diondokter/induction-heater/hardware/induction-heater-manual-control.asc

C1: cap; 220n
L1: ind; 220µ
L2: ind; 220µ
L3: ind; 87.5µ
M1: nmos; Si7336ADP
M2: nmos; Si7336ADP
R1: res; 100K
R2: res; 120
R3: res; 10k
R4: res; 120
V1: voltage; 48
V2: voltage; PULSE(0 12 0 1p 1p 12.5u 25u)
V3: voltage; PULSE(0 12 12.5u 1p 1p 12.5u 25u)
Named nets: 0, MOS_G_R, MOS_G_L, BUS_R, BUS_L
.tran 0 20m 19.8m 0.0000001 startup
