diondokter/induction-heater/hardware/induction-heater-controller/induction-heater-controller.kicad_pcb

## KiCad design hardware/induction-heater-controller/induction-heater-controller.kicad_pcb (2023-08-05)

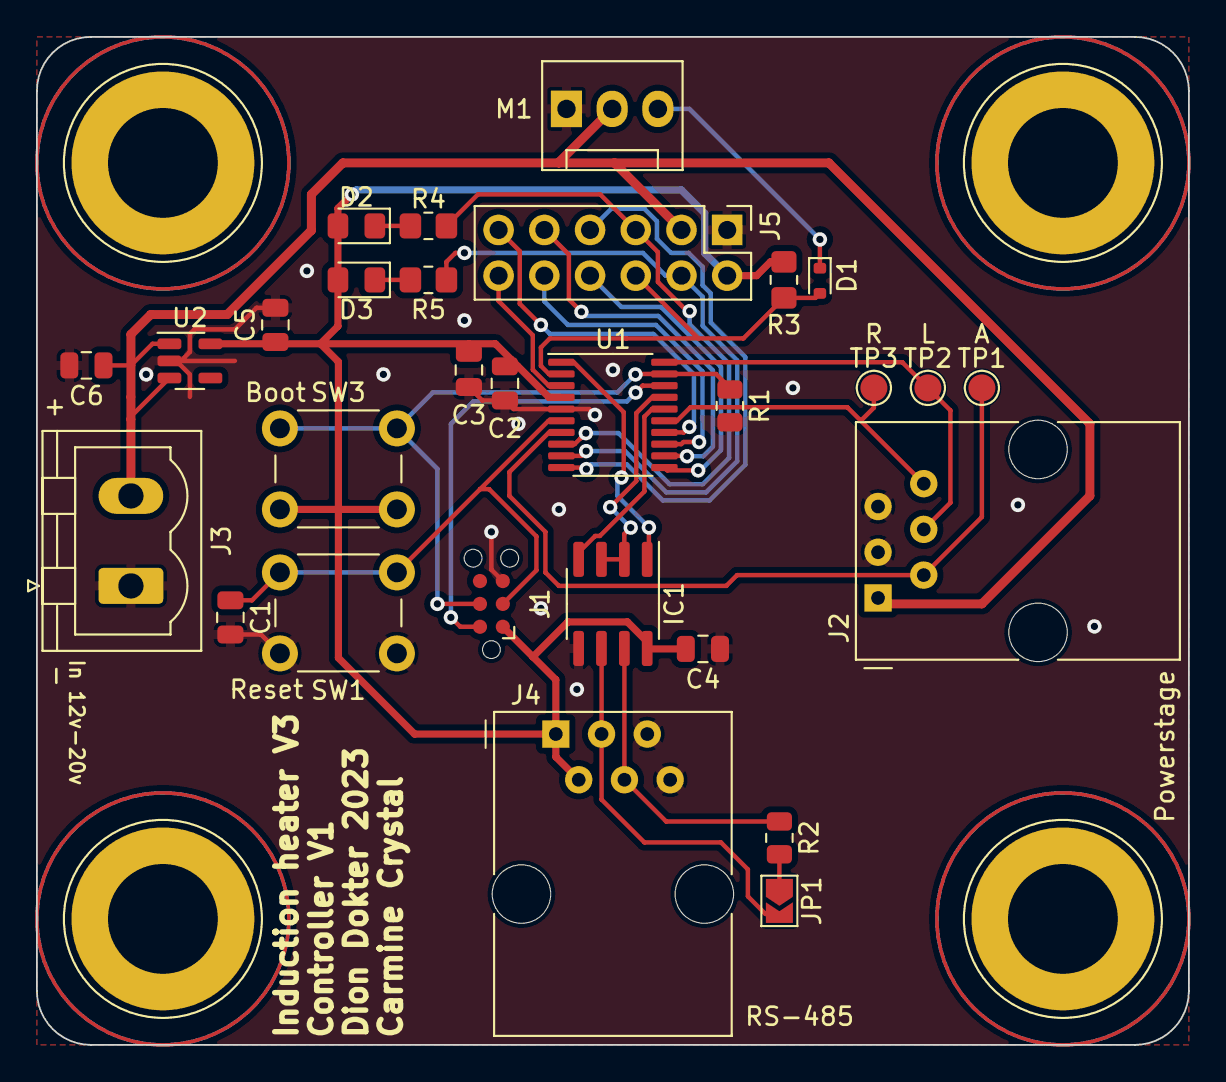
[picture p1: board induction-heater-controller.kicad_pcb from above]

Board: 2 copper layers, 64.0 x 56.0 mm, 33 parts (0 on the bottom side), 27 nets.

Parts:
C1, C2, C4: 100n; C_0805_2012Metric
C3: 4.7u; C_0805_2012Metric
C5, C6: 1u; C_0805_2012Metric
D1: D; D_SOD-523
D2, D3: LED; LED_0805_2012Metric_Pad1.15x1.40mm_HandSolder
H1, H2, H3, H4: MountingHole; Banana_Jack_1Pin
IC1: THVD1449DR; SOIC-8_3.9x4.9mm_P1.27mm
J1: Conn_ARM_SWD_TagConnect_TC2030-NL; Tag-Connect_TC2030-IDC-NL_2x03_P1.27mm_Vertical
J2, J4: RJ12; RJ12_Amphenol_54601
J3: Screw_Terminal_01x02; PhoenixContact_MSTBVA_2,5_2-G_1x02_P5.00mm_Vertical
J5: Conn_02x06_Top_Bottom; PinHeader_2x06_P2.54mm_Vertical
JP1: SolderJumper_2_Open; SolderJumper-2_P1.3mm_Open_TrianglePad1.0x1.5mm
M1: Fan_3pin; FanPinHeader_1x03_P2.54mm_Vertical
R1: 10k; R_0805_2012Metric
R2: 120; R_0805_2012Metric
R3: 10k; R_0805_2012Metric_Pad1.20x1.40mm_HandSolder
R4: 100; R_0805_2012Metric_Pad1.20x1.40mm_HandSolder
R5: 20; R_0805_2012Metric_Pad1.20x1.40mm_HandSolder
SW1, SW3: SW_Push; SW_PUSH_6mm
TP1, TP2, TP3: TestPoint; TestPoint_Pad_D1.5mm
U1: STM32G030F6Px; TSSOP-20_4.4x6.5mm_P0.65mm
U2: NCP718xSN330; SOT-23-5

Connections:
+3V3: C2.2, C3.2, C4.2, C5.1, D2.2 (A), D3.2 (A), IC1.8 (VCC), J1.1 (VCC), J4.1, J4.2, J5.2, R3.1, SW3.2, U1.4 (VDD), U2.5 (OUT)
ANALOG_L: J2.2, TP1.1, U1.7 (PA0)
DRIVER_L: J2.4, TP2.1, U1.20 (PB3/PB4/PB5/PB6)
DRIVER_R: J2.6, TP3.1, U1.15 (PB0/PB1/PB2/PA8)
FAN_TACHO: D1.2 (A), J5.6, R3.2, U1.2 (PC14/PB9)
GND: C1.2, C2.1, C3.1, C4.1, C5.2, C6.2, IC1.5 (GND), J1.5 (GND), J2.3, J2.5, J3.1, J4.5, J4.6, J5.1, M1.3 (-), R1.2, SW1.2, U1.5 (VSS), U2.2 (GND)
HEADER_7: J5.7, U1.10 (PA3)
HEADER_8: J5.8, U1.11 (PA4)
HEADER_9: J5.9, U1.12 (PA5)
HEADER_10: J5.10, U1.13 (PA6)
HEADER_11: J5.11, U1.14 (PA7)
HEADER_12: J5.12, U1.3 (PC15)
LED_G: J5.4, R5.1, U1.9 (PA2)
LED_R: J5.5, R4.1, U1.8 (PA1)
unnamed: D1.1 (K), M1.1 (Tacho)
unnamed: D2.1 (K), R4.2
unnamed: D3.1 (K), R5.2
unnamed: IC1.6 (A), J4.3, JP1.2 (B)
unnamed: IC1.7 (B), J4.4, R2.1
unnamed: C1.1, J1.3 (~RESET), SW1.1, U1.6 (NRST)
unnamed: JP1.1 (A), R2.2
RS485_DE: IC1.2 (~RE), IC1.3 (DE), U1.17 (PA12/PA10)
RS485_RX: IC1.1 (R), U1.1 (PB7/PB8)
RS485_TX: IC1.4 (D), U1.16 (PA11/PA9)
SWCLK: J1.4 (SWCLK), R1.1, SW3.1, U1.19 (PA14/PA15)
SWDIO: J1.2 (SWDIO), U1.18 (PA13)
VDC: C6.1, J2.1, J3.2, J5.3, M1.2 (+), U2.1 (IN), U2.3 (EN)
