diondokter/induction-heater/hardware/induction-heater-powerstage/induction-heater-powerstage.kicad_pcb

## KiCad design hardware/induction-heater-powerstage/induction-heater-powerstage.kicad_pcb (2023-08-05)

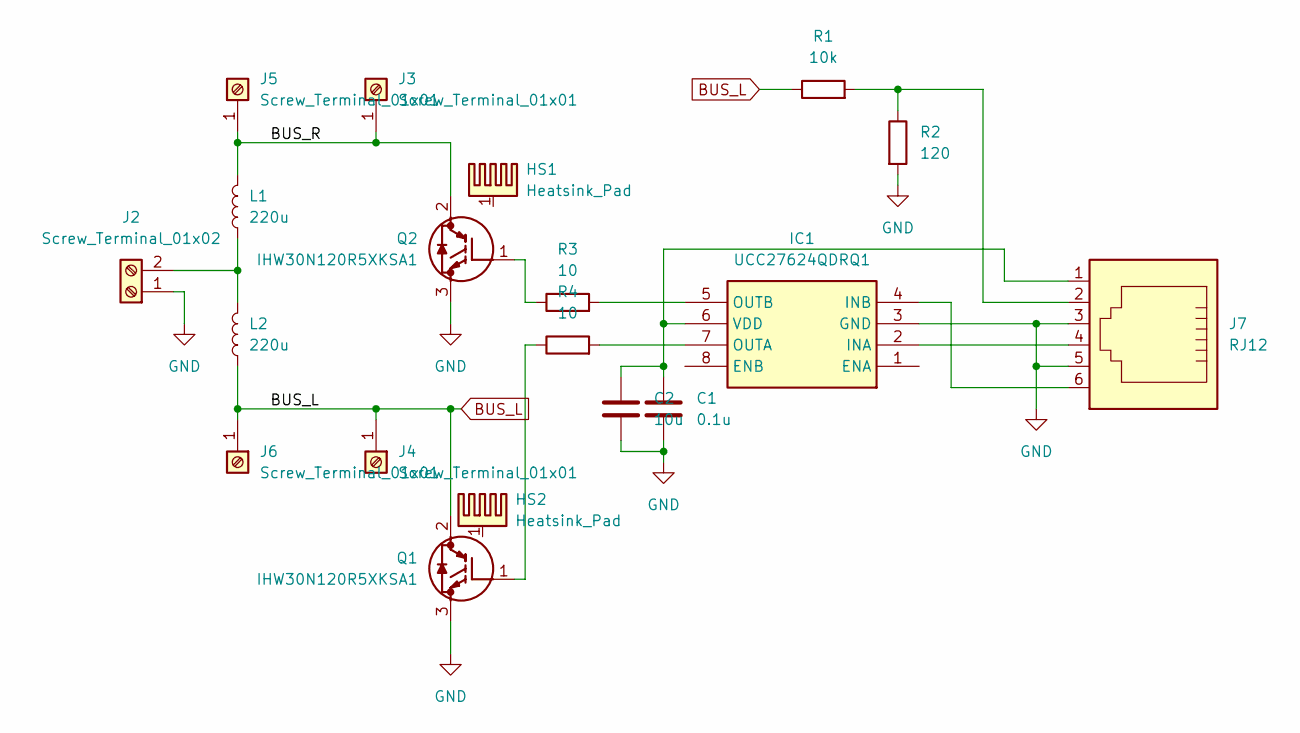
[picture p2: schematic induction-heater-powerstage.kicad_sch]

Parts:
C1: 0.1u; C_0805_2012Metric_Pad1.18x1.45mm_HandSolder
C2: 10u; C_0805_2012Metric_Pad1.18x1.45mm_HandSolder
HS1, HS2: Heatsink_Pad; Heatsink_Fischer_SK129-STS_42x25mm_2xDrill2.5mm; MPN 6398BG
IC1: UCC27624QDRQ1; SOIC127P600X175-8N; Mouser Part Number 595-UCC27624QDRQ1
J2: Screw_Terminal_01x02; PhoenixContact_MSTBVA_2,5_2-G_1x02_P5.00mm_Vertical; MPN TB007-508-02BE
J3, J4, J5, J6: Screw_Terminal_01x01; Banana_Jack_1Pin
J7: RJ12; RJ12_Amphenol_54601; MPN 54601-906WPLF
L1, L2: 220u; L_Toroid_Vertical_L31.8mm_W15.9mm_P13.50mm_Bourns_5700; MPN 2300HT-221-V-RC
Q1, Q2: IHW30N120R5XKSA1; TO544P521X1592X2557-3P; Mouser Part Number 726-IHW30N120R5XKSA1
R1: 10k; R_0805_2012Metric_Pad1.20x1.40mm_HandSolder
R2: 120; R_0805_2012Metric_Pad1.20x1.40mm_HandSolder
R3, R4: 10; R_0805_2012Metric_Pad1.20x1.40mm_HandSolder

Connections:
/BUS_R: J3.1, J5.1, L1.2, Q2.2 (C)
BUS_L: J4.1, J6.1, L2.1, Q1.2 (C), R1.1
GND: C1.2, C2.2, IC1.3 (GND), J2.1, J7.3, J7.5, Q1.3 (E), Q2.3 (E), R2.2
unnamed: IC1.2 (INA), J7.4
unnamed: IC1.4 (INB), J7.6
unnamed: IC1.7 (OUTA), R4.2
unnamed: IC1.5 (OUTB), R3.2
unnamed: C1.1, C2.1, IC1.6 (VDD), J7.1
unnamed: J2.2, L1.1, L2.2
unnamed: J7.2, R1.2, R2.1
unnamed: Q1.1 (G), R4.1
unnamed: Q2.1 (G), R3.1

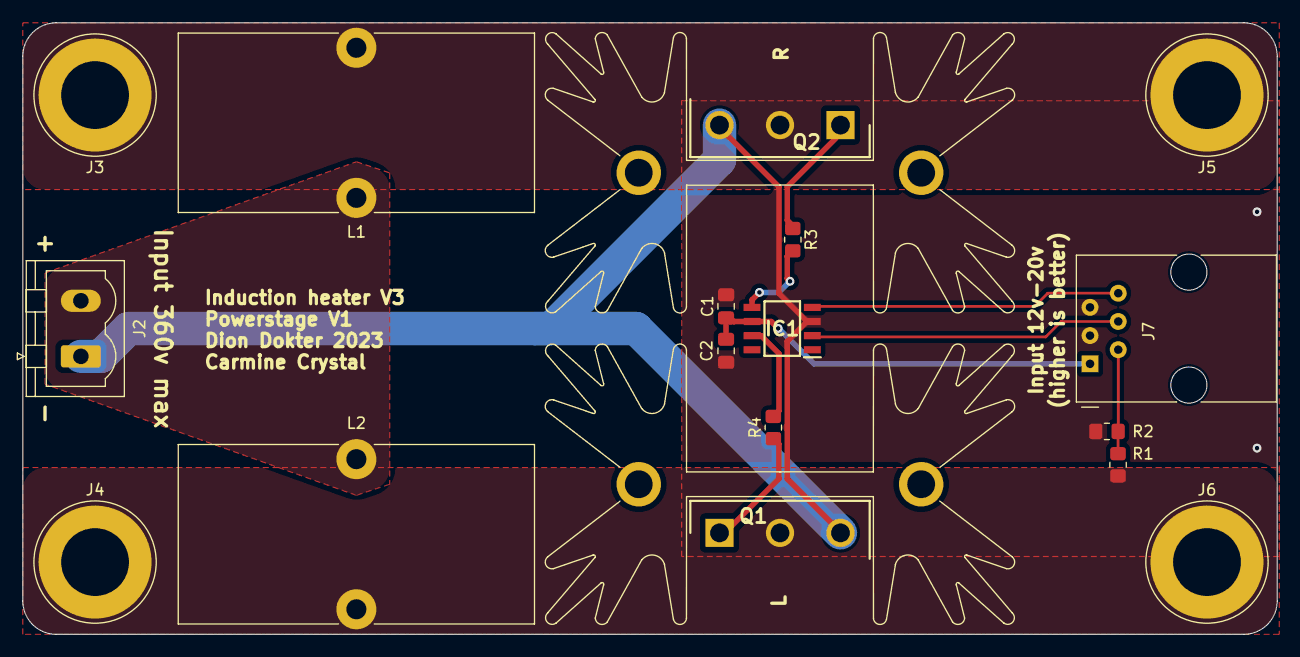
[picture p3: board induction-heater-powerstage.kicad_pcb from above]

Board: 2 copper layers, 112.8 x 55.0 mm, 19 parts (0 on the bottom side), 12 nets.
