diondokter/induction-heater/hardware/kicad/induction-heater.kicad_pcb

## KiCad design hardware/kicad/induction-heater.kicad_pcb (2023-01-13)

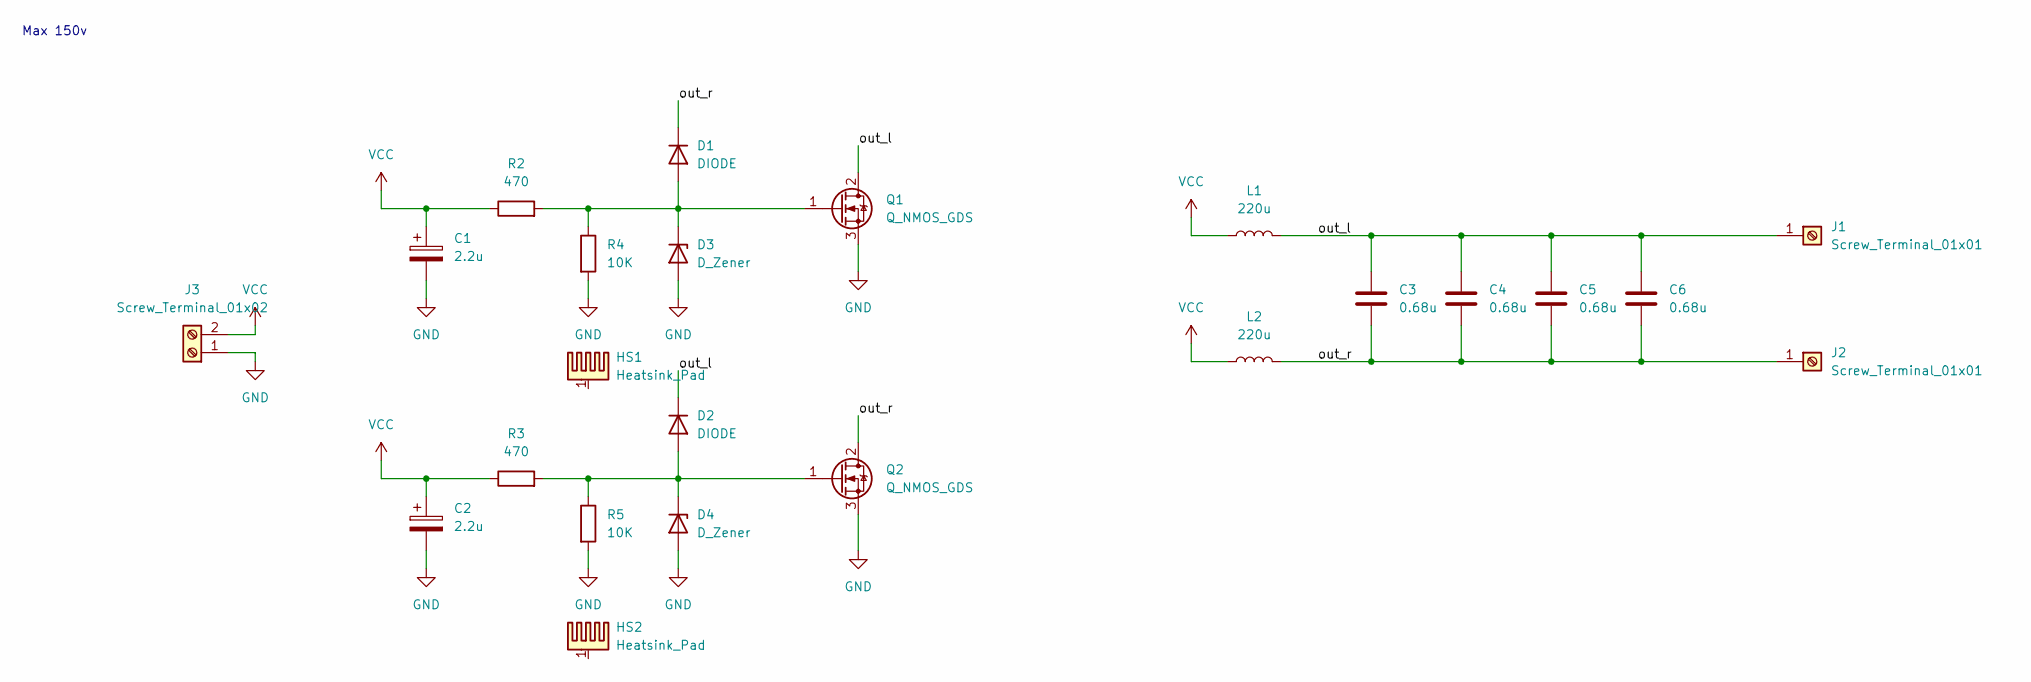
[picture p4: schematic induction-heater.kicad_sch]

Parts:
C1, C2: 2.2u; CP_Radial_D6.3mm_P2.50mm; MPN ESL225M250AE3AA
C3, C4, C5, C6: 0.68u; C_Rect_L31.5mm_W15.0mm_P27.50mm_MKS4; MPN MKS4O136806F00KYSD
D1, D2: DIODE; D_DO-41_SOD81_P7.62mm_Horizontal; MPN UF4005-E3/54
D3, D4: D_Zener; D_DO-15_P12.70mm_Horizontal; MPN 1N5927BRLG
HS1, HS2: Heatsink_Pad; Heatsink_Fischer_SK129-STS_42x25mm_2xDrill2.5mm; MPN 6398BG
J1, J2: Screw_Terminal_01x01; Banana_Jack_1Pin
J3: Screw_Terminal_01x02; PhoenixContact_MSTBVA_2,5_2-G_1x02_P5.00mm_Vertical; MPN TB007-508-02BE
L1, L2: 220u; L_Toroid_Vertical_L31.8mm_W15.9mm_P13.50mm_Bourns_5700; MPN 2300HT-221-V-RC
Q1, Q2: Q_NMOS_GDS; TO-220-3_Vertical; MPN NTP067N65S3H
R2, R3: 470; TO-220-2_Vertical; MPN AP851470RJ
R4, R5: 10K; R_Axial_DIN0516_L15.5mm_D5.0mm_P5.08mm_Vertical; MPN ROX3SJ10K

Connections:
/out_l: C3.1, C4.1, C5.1, C6.1, D2.1 (K), J1.1, L1.2, Q1.2 (D)
/out_r: C3.2, C4.2, C5.2, C6.2, D1.1 (K), J2.1, L2.2, Q2.2 (D)
GND: C1.2, C2.2, D3.2 (A), D4.2 (A), J3.1, Q1.3 (S), Q2.3 (S), R4.2, R5.2
unnamed: D1.2 (A), D3.1 (K), Q1.1 (G), R2.2, R4.1
unnamed: D2.2 (A), D4.1 (K), Q2.1 (G), R3.2, R5.1
VCC: C1.1, C2.1, J3.2, L1.1, L2.1, R2.1, R3.1

Notes on the sheet:
Max 150v

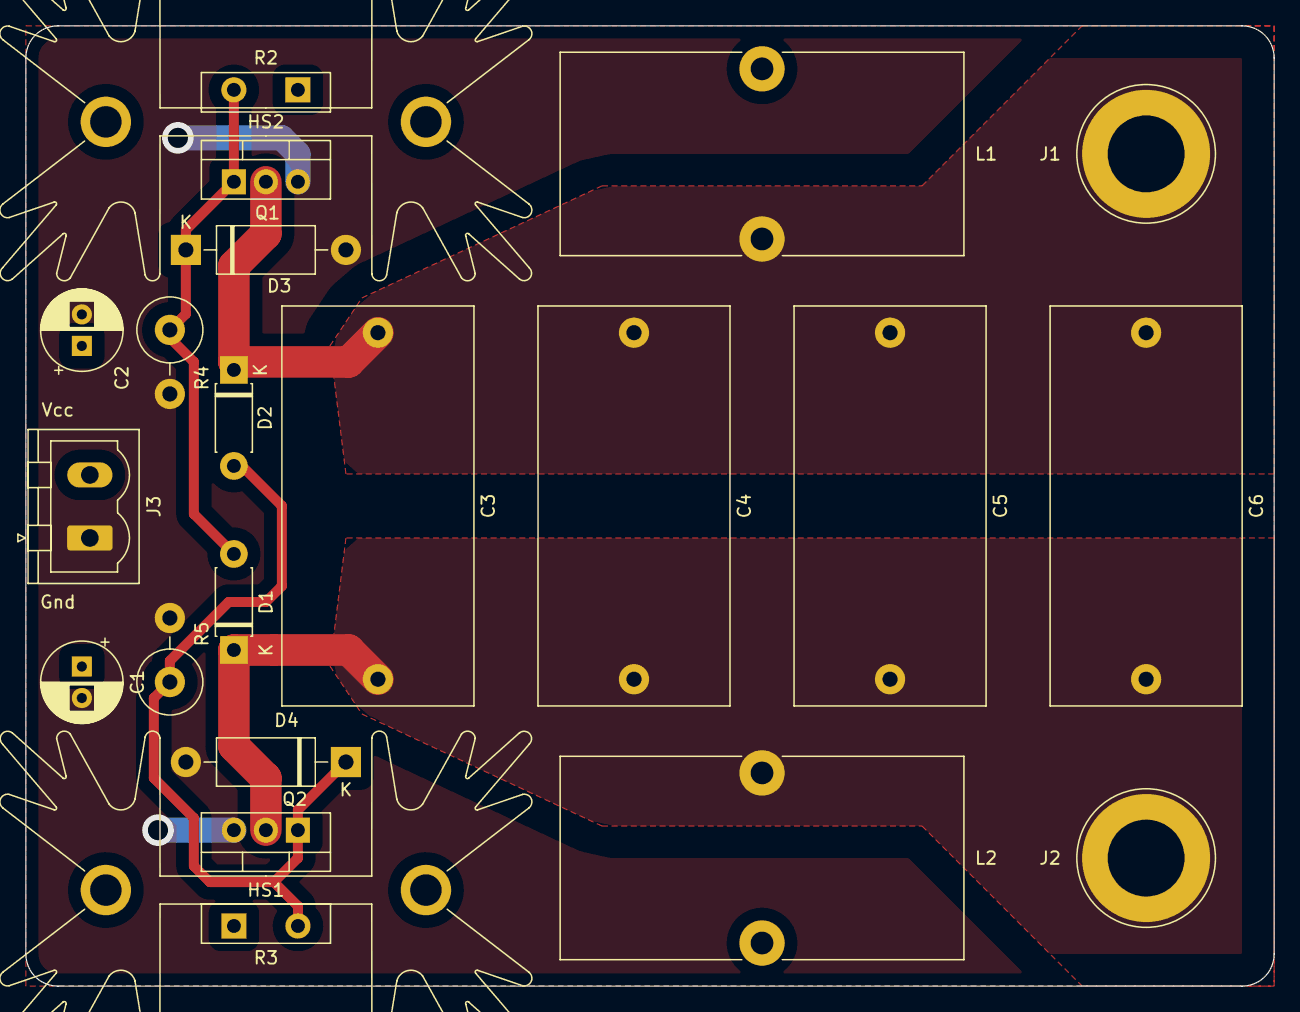
[picture p5: board induction-heater.kicad_pcb from above]

Board: 2 copper layers, 99.1 x 76.2 mm, 23 parts (0 on the bottom side), 6 nets.
