diondokter/induction-heater/(commit log)

2022-11-04 Components chosen and board layout made
    [induction-heater.kicad_pcb, induction-heater.kicad_sch]
2022-11-10 Compacter board
    [induction-heater.kicad_pcb, induction-heater.kicad_sch]
2022-11-18 Final touches on silkscreen
    [induction-heater.kicad_pcb]
2022-11-18 Changed mfr to mpn
    [induction-heater.kicad_pcb, induction-heater.kicad_sch]
2022-11-27 Improved the footprints
    [induction-heater.kicad_pcb, induction-heater.kicad_sch]
2022-11-27 Finishing up
    [induction-heater.kicad_pcb]
2022-12-02 Fixed resistor pin assignment on board
    [induction-heater.kicad_pcb]
2023-01-13 V2 done. Also added a new simulation design for a possible v3
    [induction-heater.kicad_pcb, induction-heater.kicad_sch]
2023-07-28 Started with the new version
    [induction-heater-controller.kicad_pcb, induction-heater-controller.kicad_sch, induction-heater-powerstage.kicad_pcb, induction-heater-powerstage.kicad_sch]
2023-07-29 Fixed the mosfet driver grounds
    [induction-heater-powerstage.kicad_pcb, induction-heater-powerstage.kicad_sch]
2023-08-03 Move to IGBTs
    [induction-heater-powerstage.kicad_pcb, induction-heater-powerstage.kicad_sch]
2023-08-05 Finished board for controller
    [induction-heater-controller.kicad_pcb, induction-heater-controller.kicad_sch, induction-heater-powerstage.kicad_pcb]
2023-08-05 Final components
    [induction-heater-controller.kicad_sch, induction-heater-powerstage.kicad_sch]
2023-08-13 Moved driver to own module and finished it. Added leds task. Started on measure task.
2023-08-14 Set up the full adc config. Hope it's ok!
2023-08-15 Added some math to find the best frequency for the samples
2023-08-19 Refactored ADC code
2023-08-27 Fixes + start with CLI
    [ih_modbus.rs, leds.rs, main.rs, modbus.rs, tacho_measure.rs, tui.rs]
2023-09-01 Added interrupt executor to firmware. Fixed cli modbus reconnect
    [coil_driver.rs, coil_measure.rs, ih_modbus.rs, main.rs, modbus.rs, tui.rs]
2023-09-10 Add ADC samples and refine ADC setup
2023-09-10 Faster ADC measure
2023-10-20 Move to simple pwm and slow dutycycle changes
2023-11-16 Switch polarity
2024-03-13 Actually enable and disable the pwm
